bmboucher/nixie_ticker/bom/bom.txt

00 D6_1  08 D5_1  16 D3_4  24 D2_4
01 D6_8  09 D5_8  17 D3_2  25 D2_2
02 D6_2  10 D4_4  18 D3_8  26 D1_4
03 D6_4  11 D4_2  19 D3_1  27 D1_2
04 D5_4  12 D4_1  20 D2_A  28 D1_8
05 D5_2  13 D4_P  21 D2_P  29 D1_1
06 D6_A  14 D4_A  22 D3_A  30 D1_A
07 D5_A  15 D4_8  23 D2_8  31 D2_1
