bmboucher/nixie_ticker/bom/BOM.xlsx

Name | Description | Digikey | Manufacturer | Package | Notes
Power Supply
LED1,LED2 | Green LED | 160-1423-1-ND | LTST-C171GKT | 0805 | 2.1V forward, use 2k resistor for 5mA
R1,R2 | 0.47 Ohm, 1/4W, 5% Resistor | 73L4R47JCT-ND | 73L4R47J | 1206
R3 | 1 kOhm, 1/3W, 5% Resistor | A126435DKR-ND | CRGH0805J1K0 | 0805
R4 | 13.7kOhm, 1/4W, 1% Resistor | RHM13.7KCJCT-ND | MCR18ERTF1372 | 1206
R5 | 475kOhm, 1/4W, 1% Resistor | RMCF1206FG475KCT-ND | RMCF1206FG475K | 1206
R6 | 4.02kOhm, 1/4W, 1% Resistor | RHM4.02KCJCT-ND | MCR18ERTF4021 | 1206
R7,R8 | 2kOhm, 1/8W, 5% Resistor | RMCF0805JT2K00CT-ND | RMCF0805JT2K00 | 0805
RX | 2kOhm Trimmer Pot | 3309P-202-ND | 3309P-1-202 | Through hole
C1,C5,C6 | 220uF, 25V electrolytic cap | 493-2192-1-ND | UWT1E221MNL1GS | 8x10
C2 | 680pF, 50V ceramic cap | 732-7555-1-ND | 885012205060 | 0402
C3 | 0.01uF, 50V ceramic cap | 732-7562-1-ND | 885012205067 | 0402
C4 | 3.3uF, 250V electrolytic cap | 493-9981-1-ND | UUX2E3R3MNL1GS | 8x10
C7,C8 | 1uF, 10V ceramic cap | 445-7368-1-ND | C1005X6S1A105K050BC | 0402
D1 | 250V 50nS rectifier diode | BAV21WRHGCT-ND | BAV21W RHG | SOD-123F
D2 | 100V gen purpose diode | MMBD914LT1GOSCT-ND | MMBD914LT1G | SOT-23-3
D3 | 60V schottky diode | B260A-FDICT-ND | B260A-13-F | SMA | Already bought
Q1 | 200V N-channel MOSFET | IRF630NSTRLPBFCT-ND | IRF630NSTRLPBF | D2PAK
Q2 | 65V PNP Transistor | BC856BLT3GOSCT-ND | BC856BLT3G | SOT-23-3
U1 | IC Boost Regulator | MC34063ADGOS-ND | MC34063ADG | 8-SOIC
U2 | IC 5V Buck Regulator | 1034-AP1507-50D5LDICT-ND | AP1507-50D5L-13 | TO-252-5
U3 | Level shifter | 296-12163-1-ND | CD40109BPWR | 16-TSSOP
L1 | 100uH 1.4A inductor | RLB9012-101KL-ND | RLB9012-101KL | Through hole
L2 | 47uH 2.35A inductor | RLB0913-470K-ND | RLB0913-470K | Through hole
SW1,SW2 | Switches | EG4326-ND | 400MSP1R6BLKM6QE | Through hole
Phoenix | Phoenix contact | 277-1316-ND | 1706714 | Through hole
Phoenix Sep | Phoenix contact separator | 277-6463-ND | 1870666 |  |  | 0.001
DC Jack | 2.1mm DC power jack | EJ508A-ND | EJ508A | Through hole | Already bought
F1,F2 | 500mA fuse | 507-1876-1-ND | C1F 500
