bmboucher/nixie_ticker/box/acrylic_top.dxf

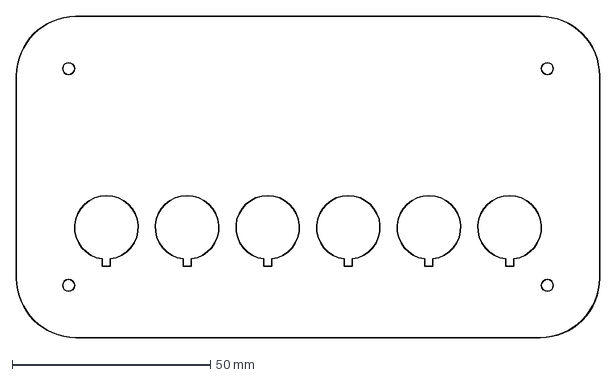
[picture p1: CAD file, 2018-09-05]
box/acrylic_top.dxf
147.0 x 81.0 mm
