bmboucher/nixie_ticker/cad/jigs/hinge_spacer.stl

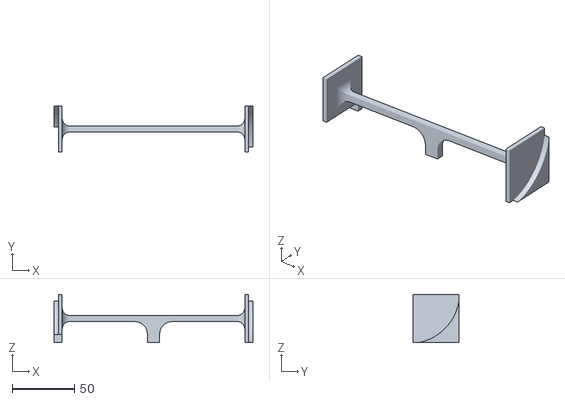
[picture p2: CAD file, 2018-09-05]
cad/jigs/hinge_spacer.stl
160.2 x 37.0 x 39.0
