bmboucher/nixie_ticker/cad/models/power_supply_board.step

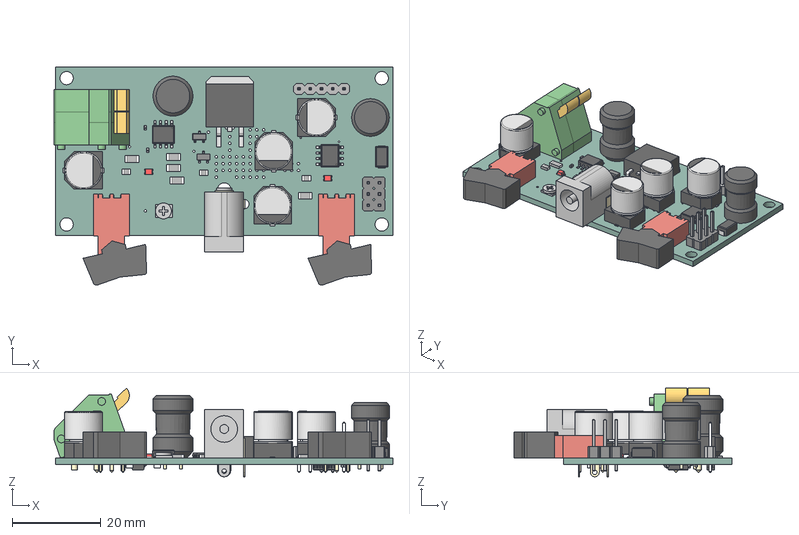
[picture p3: CAD file, 2018-08-29]
cad/models/power_supply_board.step
76.5 x 49.3 x 20.0 mm
Board
IRF630N
EJ508A
ZKFDS x 2
2X03
B260A-13-F
T411001B x 2
RLB9013
220uF x 4
SOD3616X115
SOT23
100uH
4.02k x 5
2k x 3
FUSE_1206 x 2
1X05
CD40109B_SPLITEN
AP1507SOIC-8 x 2
SOT23-BEC
2k_1
CHIP-LED0805 x 2
1uF x 4
