bmboucher/nixie_ticker/cad/parts/power_supply_spacer_back.stl

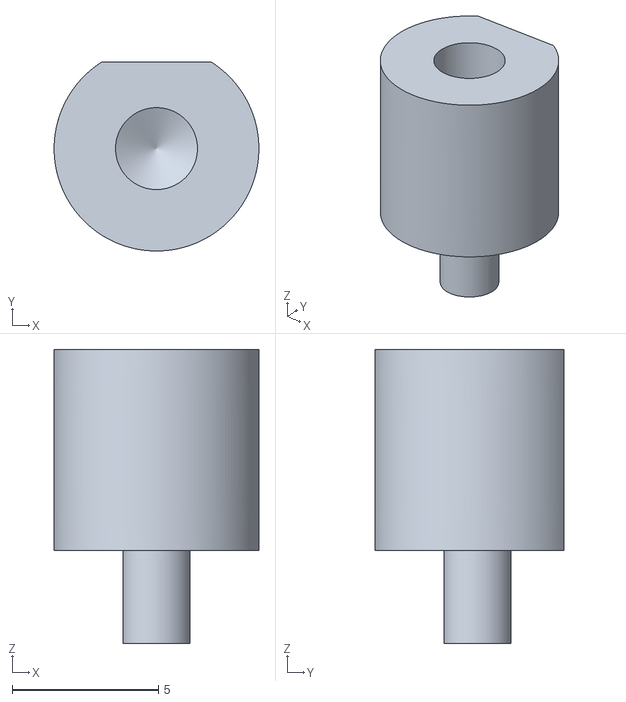
[picture p4: CAD file, 2018-09-01]
cad/parts/power_supply_spacer_back.stl
7.00 x 6.46 x 10.0
