bmboucher/nixie_ticker/box/top_piece.dxf

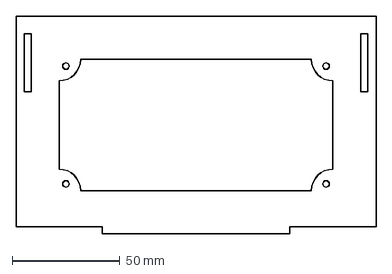
[picture p5: CAD file, 2018-07-10]
box/top_piece.dxf
167.0 x 101.0 mm
