bmboucher/nixie_ticker/cad/jigs/power_supply_stencil_spacer.stl

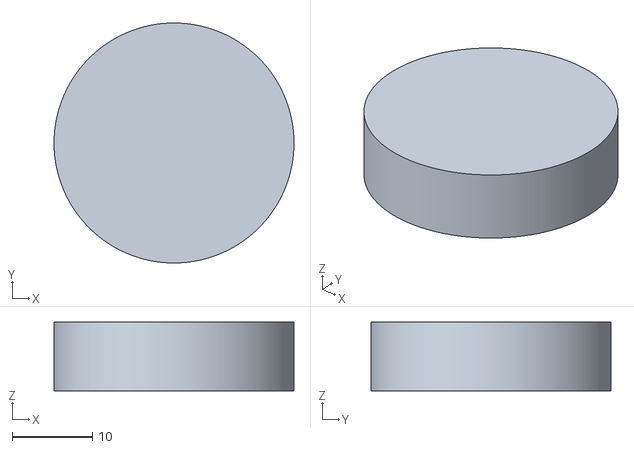
[picture p6: CAD file, 2018-08-30]
cad/jigs/power_supply_stencil_spacer.stl
30.0 x 30.0 x 8.60
