bmboucher/nixie_ticker/cad/models/in-14.step

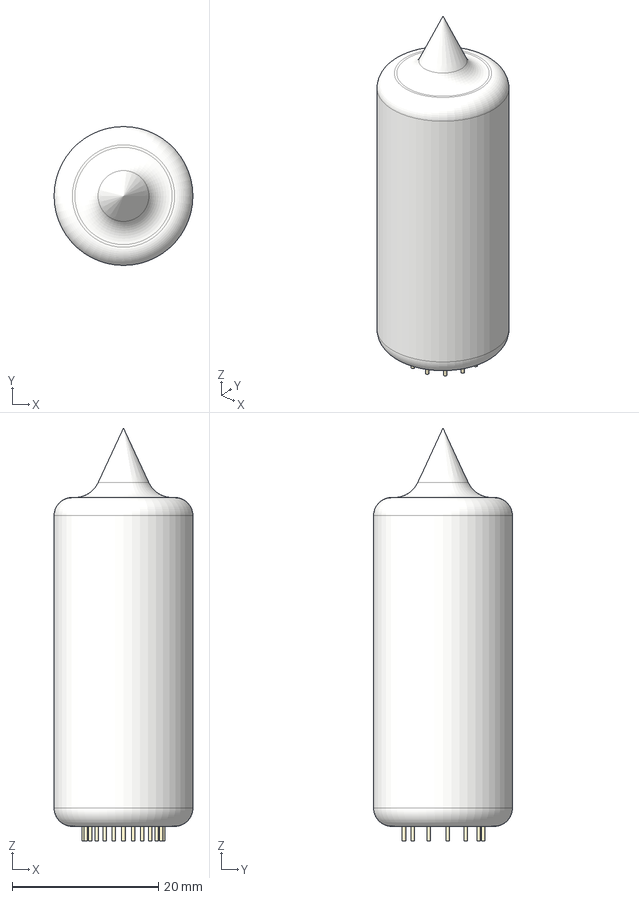
[picture p7: CAD file, 2018-08-29]
cad/models/in-14.step
19.0 x 19.0 x 56.5 mm
