bmboucher/nixie_ticker/cad/parts/power_supply_spacer_front.stl

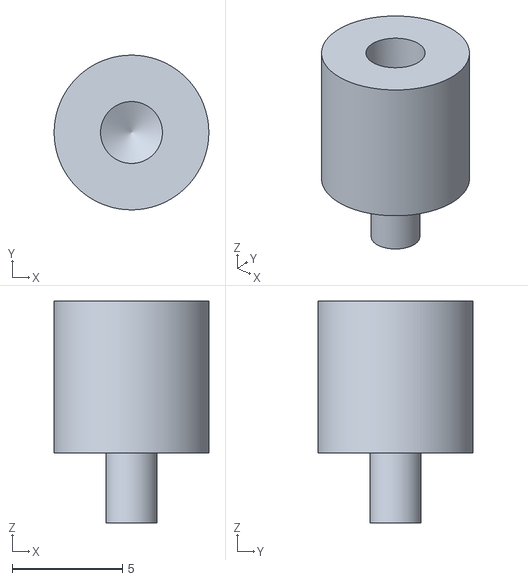
[picture p8: CAD file, 2018-09-01]
cad/parts/power_supply_spacer_front.stl
7.00 x 7.00 x 10.0
