bmboucher/nixie_ticker/box/front_piece.dxf

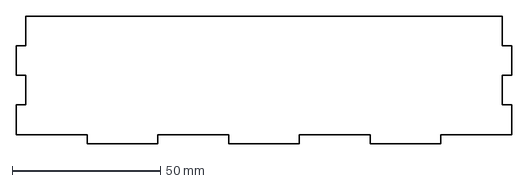
[picture p9: CAD file, 2018-07-10]
box/front_piece.dxf
167.0 x 43.2 mm
