bmboucher/nixie_ticker/cad/jigs/nixie_board_stencil_mount.stl

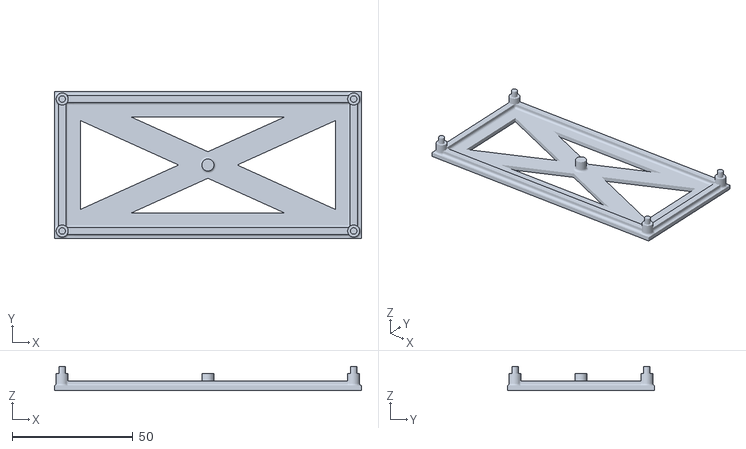
[picture p10: CAD file, 2018-08-30]
cad/jigs/nixie_board_stencil_mount.stl
127.1 x 61.0 x 10.0
