bmboucher/nixie_ticker/cad/models/nixie_board.step

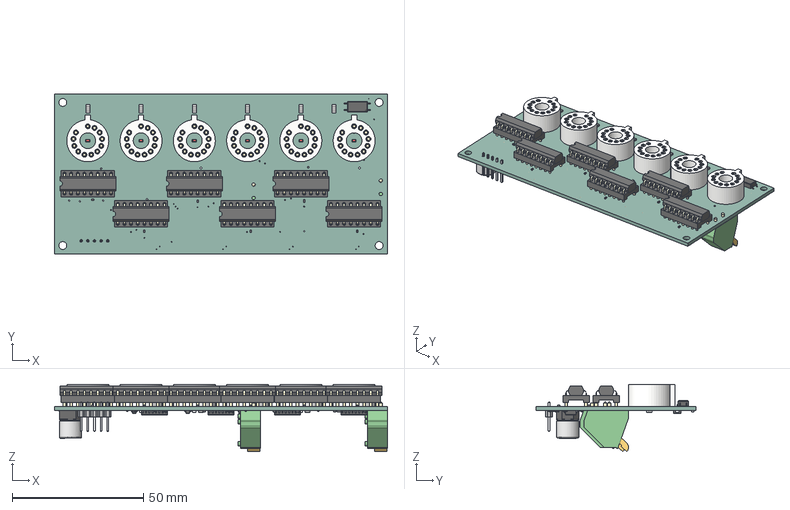
[picture p11: CAD file, 2018-08-29]
cad/models/nixie_board.step
127.0 x 61.0 x 25.7 mm
Board
BCX19SMD x 6
74AHC595 x 5
TLP3873D
ZKFDS x 2
1X05
220uF
22k x 6
10k x 12
CHIP-LED0603 x 6
C0402 x 16
100k x 12
IN14_12PIN12PIN x 6
