bmboucher/nixie_ticker/cad/parts/nixie_socket_tube.step

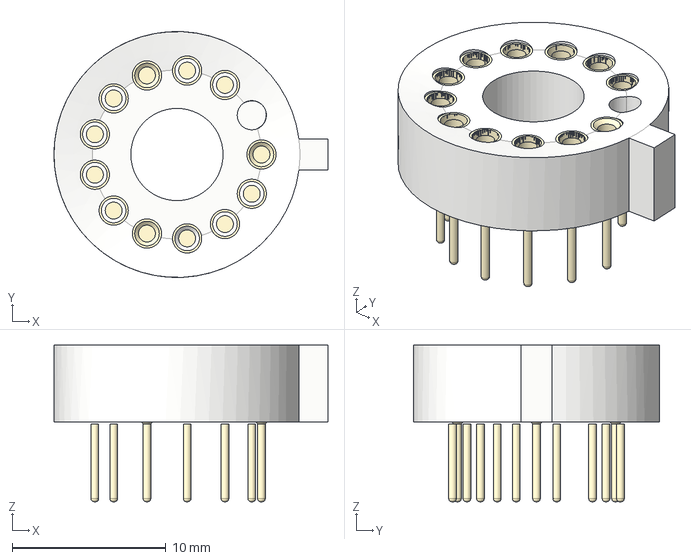
[picture p12: CAD file, 2018-08-29]
cad/parts/nixie_socket_tube.step
17.8 x 16.0 x 10.2 mm
