bmboucher/nixie_ticker/box/right_piece.dxf

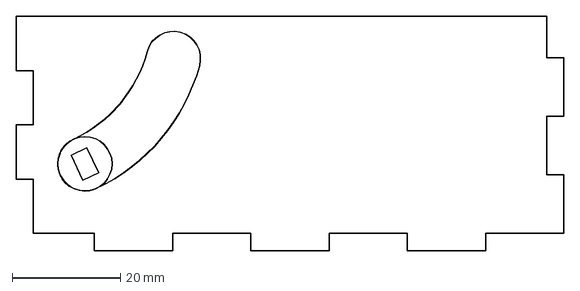
[picture p13: CAD file, 2018-07-10]
box/right_piece.dxf
101.0 x 43.2 mm
