bmboucher/nixie_ticker/cad/jigs/nixie_socket_alignment_tool.stl

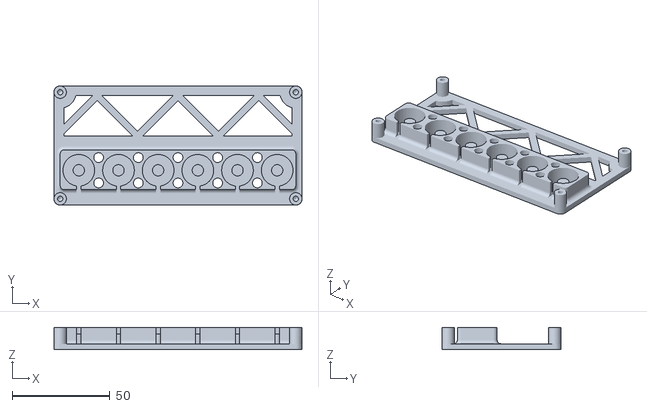
[picture p14: CAD file, 2018-08-29]
cad/jigs/nixie_socket_alignment_tool.stl
127.0 x 61.0 x 11.4
