bmboucher/nixie_ticker/cad/parts/nixie_socket_board.step

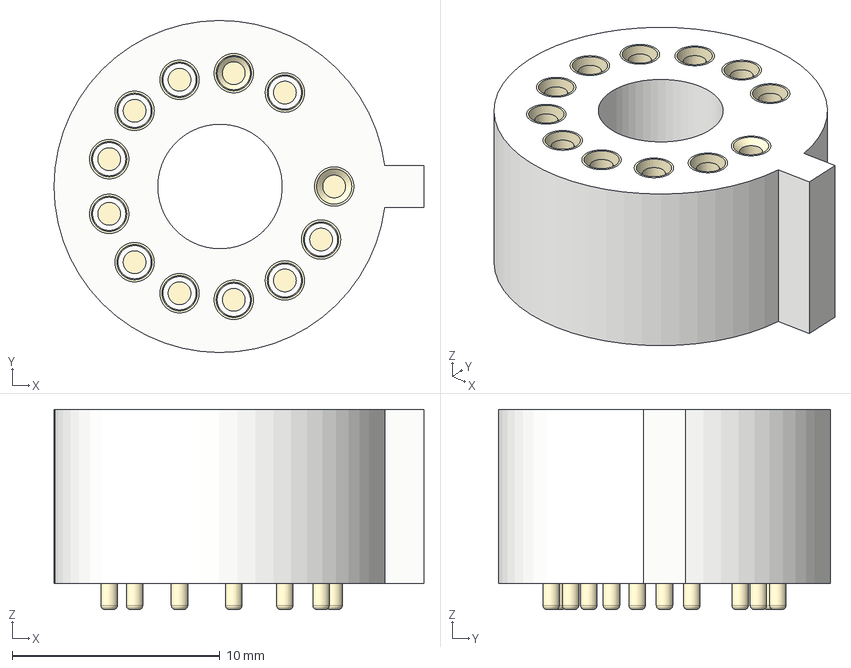
[picture p15: CAD file, 2018-08-29]
cad/parts/nixie_socket_board.step
17.8 x 16.0 x 9.64 mm
