bmboucher/nixie_ticker/box/support_3.dxf

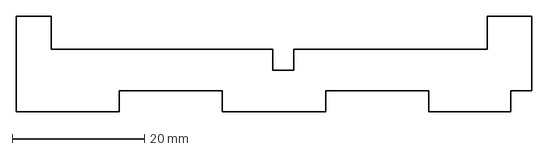
[picture p16: CAD file, 2018-07-10]
box/support_3.dxf
78.0 x 14.4 mm
