bmboucher/nixie_ticker/cad/jigs/power_supply_stencil_mount.stl

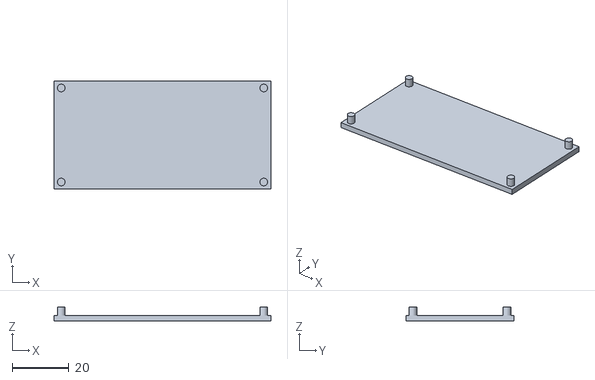
[picture p17: CAD file, 2018-08-29]
cad/jigs/power_supply_stencil_mount.stl
76.2 x 38.1 x 5.00
