bmboucher/nixie_ticker/box/left_piece.dxf

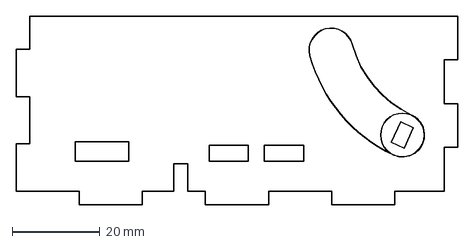
[picture p18: CAD file, 2018-07-10]
box/left_piece.dxf
101.0 x 43.2 mm
