bmboucher/nixie_ticker/cad/jigs/stencil_spacer.stl

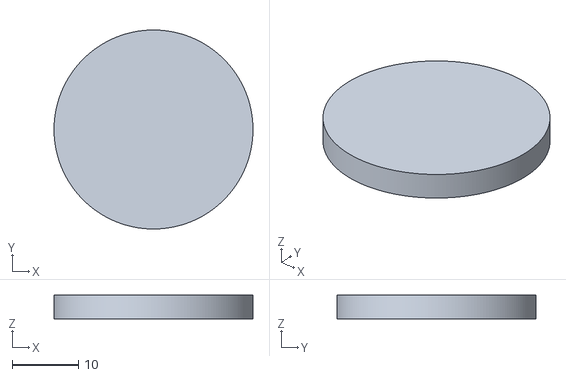
[picture p19: CAD file, 2018-08-29]
cad/jigs/stencil_spacer.stl
30.0 x 30.0 x 3.60
