bmboucher/nixie_ticker/box/bottom_piece.dxf

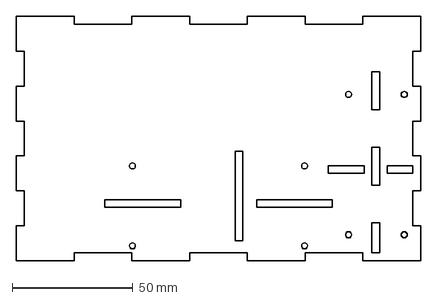
[picture p20: CAD file, 2018-07-10]
box/bottom_piece.dxf
167.0 x 101.0 mm
