bmboucher/nixie_ticker/box/hinge_circle.dxf

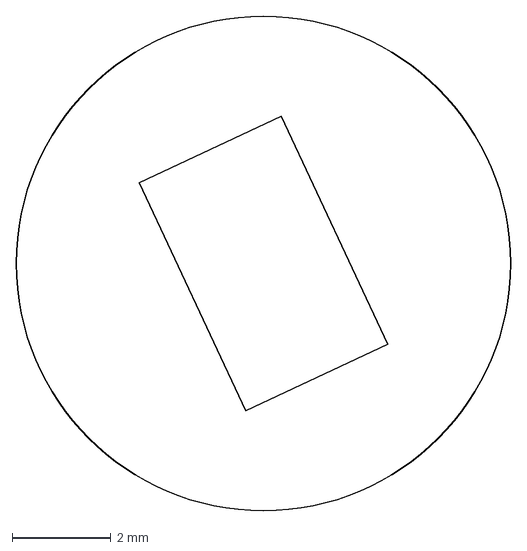
[picture p21: CAD file, 2018-07-10]
box/hinge_circle.dxf
10.00 x 10.00 mm
