bmboucher/nixie_ticker/box/support_1.dxf

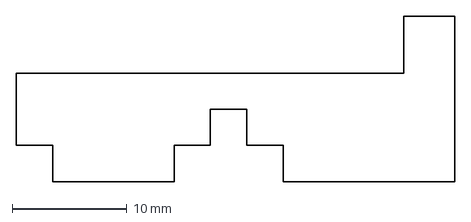
[picture p22: CAD file, 2018-07-10]
box/support_1.dxf
38.2 x 14.4 mm
