bmboucher/nixie_ticker/box/back_piece.dxf

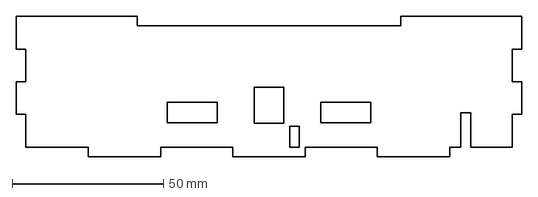
[picture p23: CAD file, 2018-07-10]
box/back_piece.dxf
167.0 x 46.3 mm
