bmboucher/nixie_ticker/box/support_2.dxf

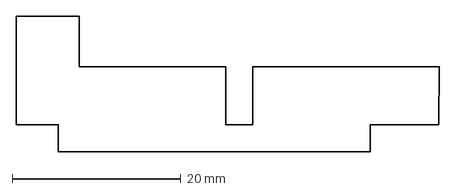
[picture p24: CAD file, 2018-07-10]
box/support_2.dxf
50.2 x 16.0 mm
