bmboucher/nixie_ticker/box/support_4.dxf

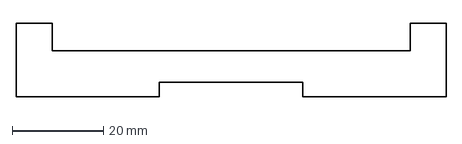
[picture p25: CAD file, 2018-07-10]
box/support_4.dxf
94.0 x 16.0 mm
