bmboucher/nixie_ticker/box/hinge_insert.dxf

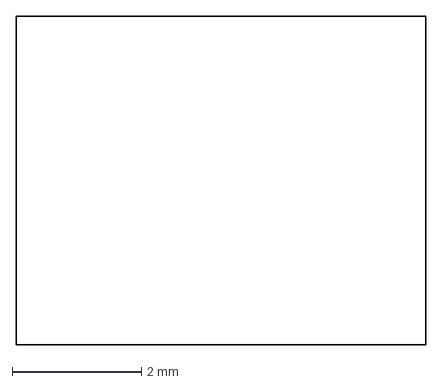
[picture p26: CAD file, 2018-07-10]
box/hinge_insert.dxf
6.35 x 5.09 mm
