bmboucher/nixie_ticker/box/hinge_piece.dxf

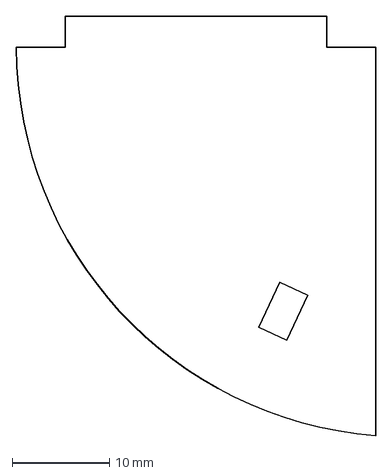
[picture p27: CAD file, 2018-07-10]
box/hinge_piece.dxf
37.0 x 43.2 mm
