bmboucher/nixie_ticker/(list of files, cad)

Other CAD files:
cad/parts/nixie_socket_board.stl
cad/parts/nixie_socket_tube.stl
