bmboucher/nixie_ticker/hardware/nixie_ticker.brd

## EAGLE design hardware/nixie_ticker.brd (2018-08-29)

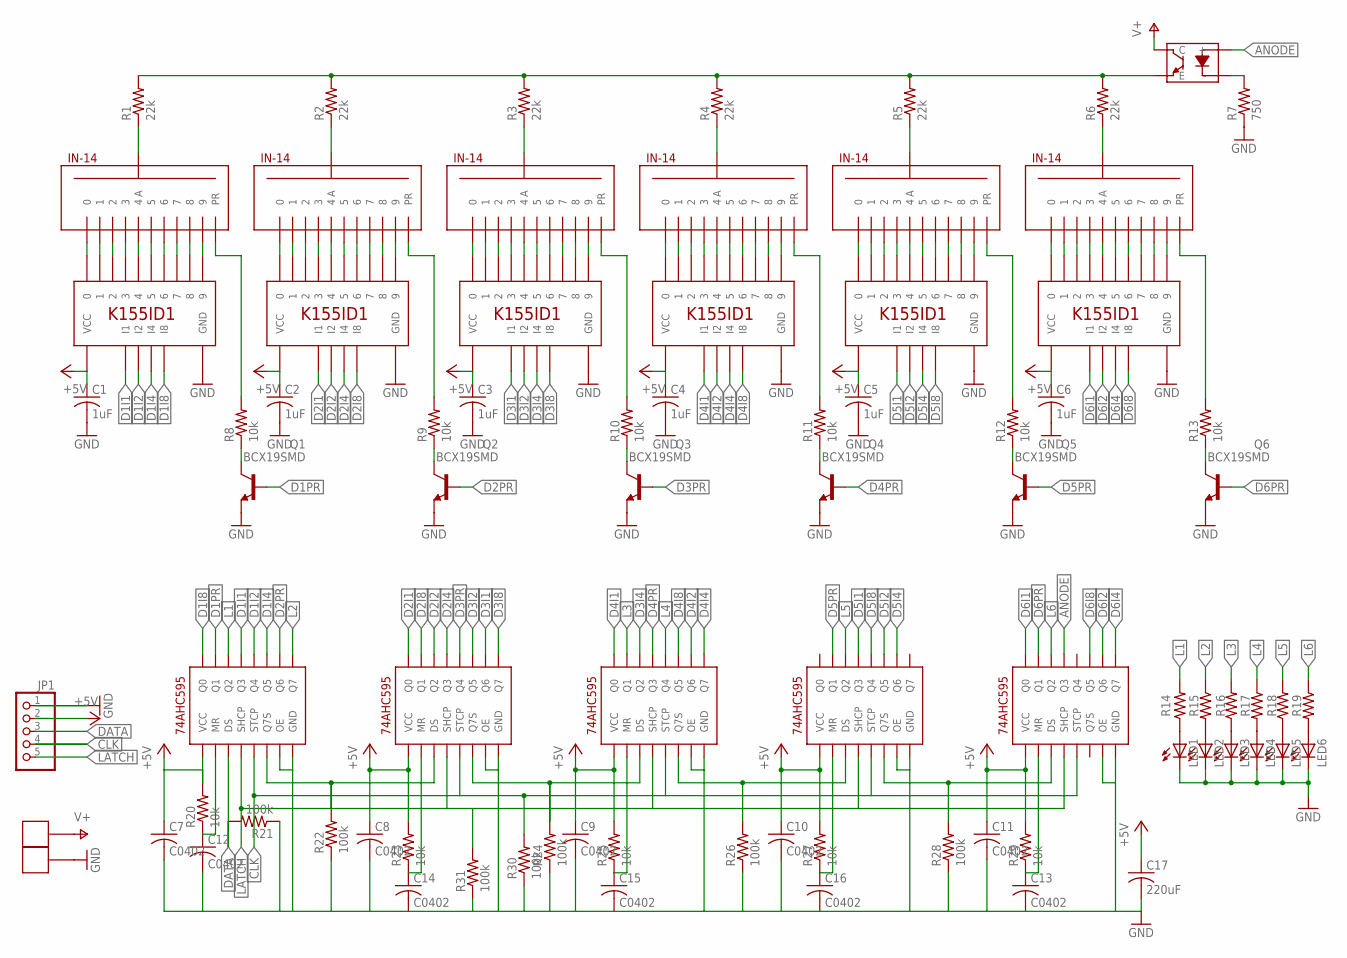
[picture p28: schematic nixie_ticker.sch]

Parts:
C1, C2, C3, C4, C5, C6: 1uF; C0402
C7, C8, C9, C10, C11, C12, C13, C14, C15, C16: C0402
C17: 220uF; CAPAE830X1050
JP1: PINHD-1X5; 1X05
JP2, JP3: ZKFDS
LED1, LED2, LED3, LED4, LED5, LED6: LEDCHIP-LED0603; CHIP-LED0603
N1, N2, N3, N4, N5, N6: IN14_12PIN12PIN; IN14-12PIN
Q1, Q2, Q3, Q4, Q5, Q6: BCX19SMD; SOT23-BEC
R1, R2, R3, R4, R5, R6: 22k; R1206
R7: 750; R0603
R8, R9, R10, R11, R12, R13: 10k; R0805
R14, R15, R16, R17, R18, R19: R-US_R0805; R0805
R20, R23, R25, R27, R29: 10k; R0402
R21, R22, R24, R26, R28, R30, R31: 100k; R0402
U1: TLP3873D; SOP254P1000X215-4
U2, U3, U4, U5, U6, U7: K155ID1; DIP-16_SMD
U8, U9, U10, U11, U12: 74AHC595; 16SOIC

Connections:
+5V: C1.1 (+), C2.1 (+), C3.1 (+), C4.1 (+), C5.1 (+), C6.1 (+), C7.1 (+), C8.1 (+), C9.1 (+), C10.1 (+), C11.1 (+), C17.1 (+), JP1.2, R20.2, R23.2, R25.2, R27.2, R29.2, U2.P$5 (VCC), U3.P$5 (VCC), U4.P$5 (VCC), U5.P$5 (VCC), U6.P$5 (VCC), U7.P$5 (VCC), U8.P$16 (VCC), U9.P$16 (VCC), U10.P$16 (VCC), U11.P$16 (VCC), U12.P$16 (VCC)
ANODE: U1.1 (+), U12.P$3 (Q3)
CLK: JP1.4, R30.2, U8.P$12 (STCP), U9.P$12 (STCP), U10.P$12 (STCP), U11.P$12 (STCP), U12.P$12 (STCP)
D1I1: U2.P$3 (I1), U8.P$3 (Q3)
D1I2: U2.P$6 (I2), U8.P$4 (Q4)
D1I4: U2.P$7 (I4), U8.P$5 (Q5)
D1I8: U2.P$4 (I8), U8.P$15 (Q0)
D1PR: Q1.B, U8.P$1 (Q1)
D2I1: U3.P$3 (I1), U9.P$15 (Q0)
D2I2: U3.P$6 (I2), U9.P$2 (Q2)
D2I4: U3.P$7 (I4), U9.P$3 (Q3)
D2I8: U3.P$4 (I8), U9.P$1 (Q1)
D2PR: Q2.B, U8.P$6 (Q6)
D3I1: U4.P$3 (I1), U9.P$6 (Q6)
D3I2: U4.P$6 (I2), U9.P$5 (Q5)
D3I4: U4.P$7 (I4), U10.P$2 (Q2)
D3I8: U4.P$4 (I8), U9.P$7 (Q7)
D3PR: Q3.B, U9.P$4 (Q4)
D4I1: U5.P$3 (I1), U10.P$15 (Q0)
D4I2: U5.P$6 (I2), U10.P$6 (Q6)
D4I4: U5.P$7 (I4), U10.P$7 (Q7)
D4I8: U5.P$4 (I8), U10.P$5 (Q5)
D4PR: Q4.B, U10.P$3 (Q3)
D5I1: U6.P$3 (I1), U11.P$3 (Q3)
D5I2: U6.P$6 (I2), U11.P$5 (Q5)
D5I4: U6.P$7 (I4), U11.P$6 (Q6)
D5I8: U6.P$4 (I8), U11.P$4 (Q4)
D5PR: Q5.B, U11.P$1 (Q1)
D6I1: U7.P$3 (I1), U12.P$15 (Q0)
D6I2: U7.P$6 (I2), U12.P$6 (Q6)
D6I4: U7.P$7 (I4), U12.P$7 (Q7)
D6I8: U7.P$4 (I8), U12.P$5 (Q5)
D6PR: Q6.B, U12.P$1 (Q1)
DATA: JP1.3, R21.2, U8.P$14 (DS)
GND: C1.2 (-), C2.2 (-), C3.2 (-), C4.2 (-), C5.2 (-), C6.2 (-), C7.2 (-), C8.2 (-), C9.2 (-), C10.2 (-), C11.2 (-), C12.2 (-), C13.2 (-), C14.2 (-), C15.2 (-), C16.2 (-), C17.2 (-), JP1.1, JP3.P$1, JP3.P$2, LED1.C, LED2.C, LED3.C, LED4.C, LED5.C, LED6.C, Q1.E, Q2.E, Q3.E, Q4.E, Q5.E, Q6.E, R7.1, R21.1, R22.1, R24.1, R26.1, R28.1, R30.1, R31.1, U2.P$12 (GND), U3.P$12 (GND), U4.P$12 (GND), U5.P$12 (GND), U6.P$12 (GND), U7.P$12 (GND), U8.P$8 (GND), U8.P$13 (OE), U9.P$8 (GND), U9.P$13 (OE), U10.P$8 (GND), U10.P$13 (OE), U11.P$8 (GND), U11.P$13 (OE), U12.P$8 (GND), U12.P$13 (OE)
L1: R14.2, U8.P$2 (Q2)
L2: R15.1, U8.P$7 (Q7)
L3: R16.2, U10.P$1 (Q1)
L4: R17.1, U10.P$4 (Q4)
L5: R18.2, U11.P$2 (Q2)
L6: R19.1, U12.P$2 (Q2)
LATCH: JP1.5, R31.2, U8.P$11 (SHCP), U9.P$11 (SHCP), U10.P$11 (SHCP), U11.P$11 (SHCP), U12.P$11 (SHCP)
unnamed: N1.P$12 (0), U2.P$16 (0)
unnamed: N1.P$3 (1), U2.P$15 (1)
unnamed: N1.P$4 (2), U2.P$8 (2)
unnamed: N1.P$5 (3), U2.P$9 (3)
unnamed: N1.P$6 (4), U2.P$13 (4)
unnamed: N1.P$7 (5), U2.P$14 (5)
unnamed: N1.P$8 (6), U2.P$11 (6)
unnamed: N1.P$9 (7), U2.P$10 (7)
unnamed: N1.P$10 (8), U2.P$1 (8)
unnamed: N1.P$11 (9), U2.P$2 (9)
unnamed: N2.P$12 (0), U3.P$16 (0)
unnamed: N2.P$3 (1), U3.P$15 (1)
unnamed: N2.P$4 (2), U3.P$8 (2)
unnamed: N2.P$5 (3), U3.P$9 (3)
unnamed: N2.P$6 (4), U3.P$13 (4)
unnamed: N2.P$7 (5), U3.P$14 (5)
unnamed: N2.P$8 (6), U3.P$11 (6)
unnamed: N2.P$9 (7), U3.P$10 (7)
unnamed: N2.P$10 (8), U3.P$1 (8)
unnamed: N2.P$11 (9), U3.P$2 (9)
unnamed: R24.2, U9.P$9 (Q7S), U10.P$14 (DS)
unnamed: R22.2, U8.P$9 (Q7S), U9.P$14 (DS)
unnamed: R26.2, U10.P$9 (Q7S), U11.P$14 (DS)
unnamed: R28.2, U11.P$9 (Q7S), U12.P$14 (DS)
unnamed: LED2.A, R15.2
unnamed: C13.1 (+), R29.1, U12.P$10 (MR)
unnamed: LED3.A, R16.1
unnamed: LED1.A, R14.1
unnamed: LED4.A, R17.2
unnamed: N3.P$12 (0), U4.P$16 (0)
unnamed: N3.P$3 (1), U4.P$15 (1)
unnamed: N3.P$4 (2), U4.P$8 (2)
unnamed: N3.P$5 (3), U4.P$9 (3)
unnamed: N3.P$6 (4), U4.P$13 (4)
unnamed: N3.P$7 (5), U4.P$14 (5)
unnamed: N3.P$8 (6), U4.P$11 (6)
unnamed: N3.P$9 (7), U4.P$10 (7)
unnamed: N3.P$10 (8), U4.P$1 (8)
unnamed: N3.P$11 (9), U4.P$2 (9)
unnamed: LED5.A, R18.1
unnamed: LED6.A, R19.2
unnamed: N1.P$2 (PR), R8.2
unnamed: Q1.C, R8.1
unnamed: N3.P$2 (PR), R10.2
unnamed: Q3.C, R10.1
unnamed: N5.P$2 (PR), R12.2
unnamed: Q5.C, R12.1
unnamed: N6.P$2 (PR), R13.2
unnamed: Q6.C, R13.1
unnamed: N1.P$1 (A), R1.1
unnamed: N4.P$12 (0), U5.P$16 (0)
unnamed: N4.P$3 (1), U5.P$15 (1)
unnamed: N4.P$4 (2), U5.P$8 (2)
unnamed: N4.P$5 (3), U5.P$9 (3)
unnamed: N4.P$6 (4), U5.P$13 (4)
unnamed: N4.P$7 (5), U5.P$14 (5)
unnamed: N4.P$8 (6), U5.P$11 (6)
unnamed: N4.P$9 (7), U5.P$10 (7)
unnamed: N4.P$10 (8), U5.P$1 (8)
unnamed: N4.P$11 (9), U5.P$2 (9)
unnamed: N5.P$1 (A), R5.1
unnamed: N5.P$12 (0), U6.P$16 (0)
unnamed: N5.P$3 (1), U6.P$15 (1)
unnamed: N5.P$4 (2), U6.P$8 (2)
unnamed: N5.P$5 (3), U6.P$9 (3)
unnamed: N5.P$6 (4), U6.P$13 (4)
unnamed: N5.P$7 (5), U6.P$14 (5)
unnamed: N5.P$8 (6), U6.P$11 (6)
unnamed: N5.P$9 (7), U6.P$10 (7)
unnamed: N5.P$10 (8), U6.P$1 (8)
unnamed: N5.P$11 (9), U6.P$2 (9)
unnamed: R1.2, R2.2, R3.2, R4.2, R5.2, R6.2, U1.3 (E)
unnamed: R7.2, U1.2 (-)
unnamed: N6.P$1 (A), R6.1
unnamed: N2.P$1 (A), R2.1
unnamed: C14.1 (+), R23.1, U9.P$10 (MR)
unnamed: C12.1 (+), R20.1, U8.P$10 (MR)
unnamed: C15.1 (+), R25.1, U10.P$10 (MR)
unnamed: C16.1 (+), R27.1, U11.P$10 (MR)
unnamed: N3.P$1 (A), R3.1
unnamed: N6.P$12 (0), U7.P$16 (0)
unnamed: N6.P$3 (1), U7.P$15 (1)
unnamed: N6.P$4 (2), U7.P$8 (2)
unnamed: N6.P$5 (3), U7.P$9 (3)
unnamed: N6.P$6 (4), U7.P$13 (4)
unnamed: N6.P$7 (5), U7.P$14 (5)
unnamed: N6.P$8 (6), U7.P$11 (6)
unnamed: N6.P$9 (7), U7.P$10 (7)
unnamed: N6.P$10 (8), U7.P$1 (8)
unnamed: N6.P$11 (9), U7.P$2 (9)
unnamed: N4.P$1 (A), R4.1
unnamed: Q2.C, R9.1
unnamed: Q4.C, R11.1
unnamed: N4.P$2 (PR), R11.2
unnamed: N2.P$2 (PR), R9.2
V+: JP2.P$1, JP2.P$2, U1.4 (C)

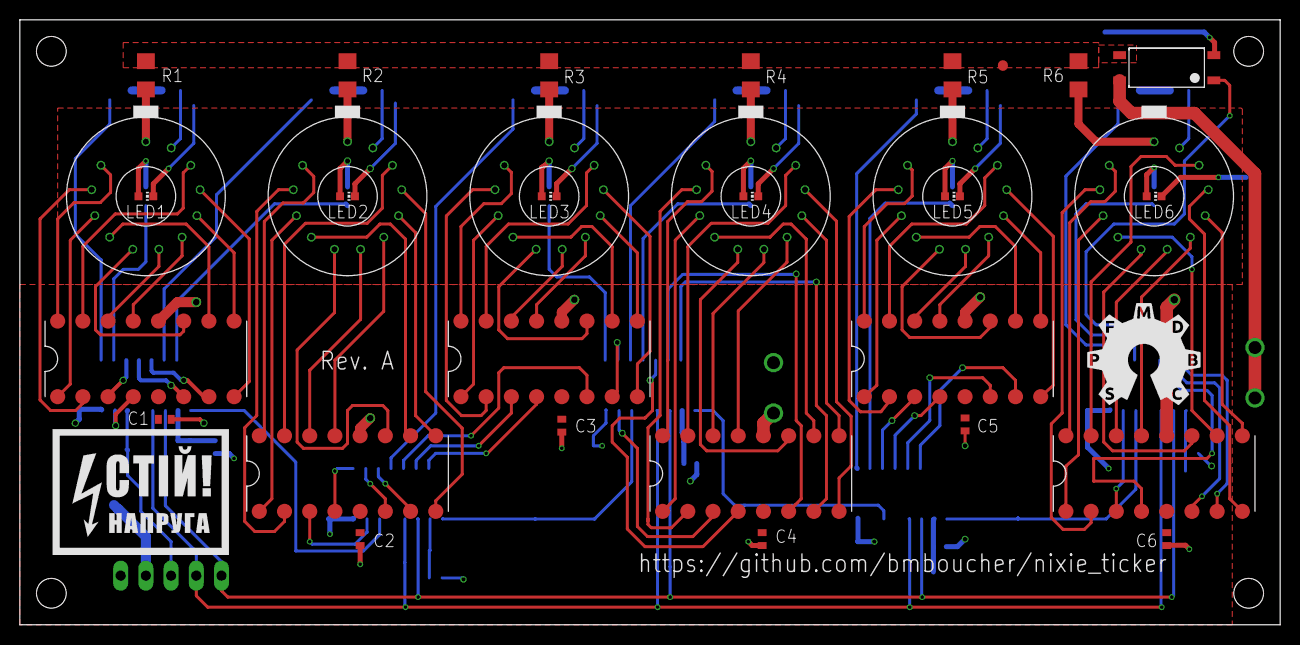
[picture p29: board nixie_ticker.brd from above]

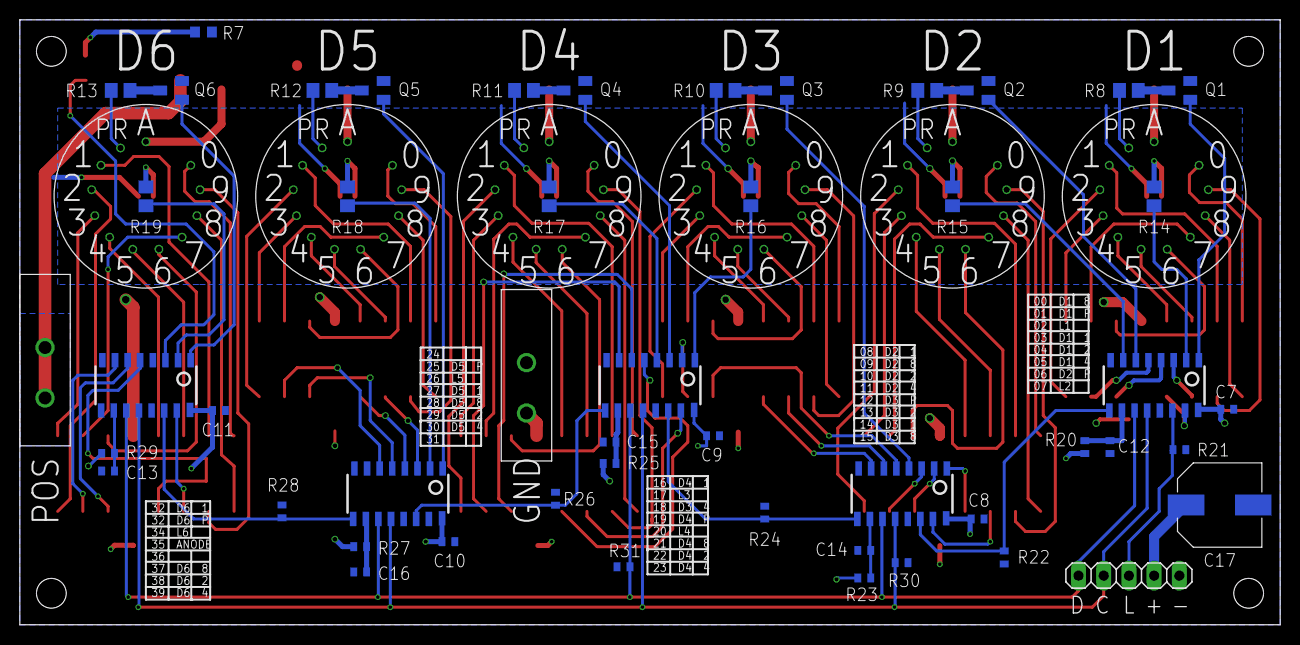
[picture p30: board nixie_ticker.brd from below]

Board: 2 copper layers, 127.0 x 61.0 mm, 81 parts (50 on the bottom side), 138 nets.
