bmboucher/nixie_ticker/hardware/power_supply.brd

## EAGLE design hardware/power_supply.brd (2018-08-29)

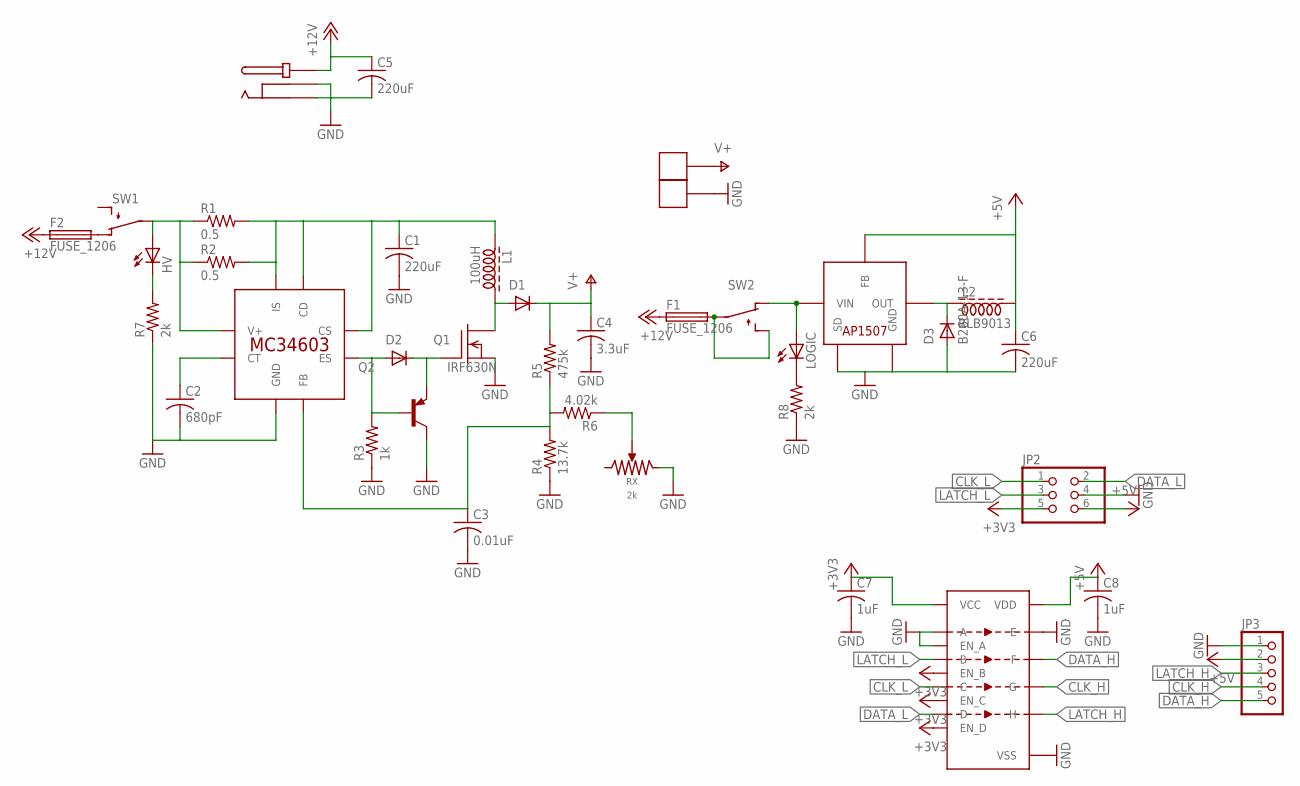
[picture p31: schematic power_supply.sch]

Parts:
C1, C5, C6: 220uF; CAPAE830X1050
C2: 680pF; C0402
C3: 0.01uF; C0402
C4: 3.3uF; CAPAE830X1050
C7, C8: 1uF; C0402
D1: BAV21W; SOD3616X115
D2: MMBD914L; SOT23
D3: B260A-13-F; DIOM4326X230
F1, F2: FUSE_1206; R1206
HV: LEDCHIP-LED0805; CHIP-LED0805
JP2: PINHD-2X3; 2X03
JP3: PINHD-1X5; 1X05
L1: 100uH; RLB9012
L2: RLB9013
LOGIC: LEDCHIP-LED0805; CHIP-LED0805
Q1: IRF630N; TO254P1524X483-3
Q2: BC807-16-PNP-SOT23-BEC; SOT23-BEC
R1, R2: 0.5; R1206
R3: 1k; R0805
R4: 13.7k; R1206
R5: 475k; R1206
R6: 4.02k; R1206
R7, R8: 2k; R0805
RX: 2k; TC33X-2
SW1, SW2: T411001B
U1: MC34063; SOIC127P600X175-8
U2: AP1507SOIC-8; SOIC127P600X175-8
U3: CD40109B_SPLITEN; SOP65P640X120-16
U$1: EJ508A
U$5, U$6: ZKFDS

Connections:
+3V3: C7.1 (+), JP2.5, U3.1 (VCC), U3.7 (EN_B), U3.9 (EN_C), U3.15 (EN_D)
+5V: C6.1 (+), C8.1 (+), JP2.6, JP3.2, L2.P$2 (2), U2.3 (FB), U3.16 (VDD)
+12V: C5.1 (+), F1.1, F2.1, U$1.P$1
CLK_H: JP3.4, U3.11 (G)
CLK_L: JP2.1, U3.10 (C)
DATA_H: JP3.5, U3.5 (F)
DATA_L: JP2.2, U3.14 (D)
GND: C1.2 (-), C2.2 (-), C3.2 (-), C4.2 (-), C5.2 (-), C6.2 (-), C7.2 (-), C8.2 (-), D3.2 (A), JP2.4, JP3.1, Q1.2 (S), Q2.C, R3.1, R4.1, R7.1, R8.1, RX.P$3, U1.4 (GND), U2.4 (SD), U2.5 (GND), U2.6 (GND), U2.7 (GND), U2.8 (GND), U3.2 (EN_A), U3.3 (A), U3.4 (E), U3.8 (VSS), U3.12 (VSS), U$1.P$2, U$1.P$3, U$6.P$1, U$6.P$2
LATCH_H: JP3.3, U3.13 (H)
LATCH_L: JP2.3, U3.6 (B)
unnamed: C1.1 (+), L1.P$1 (1), R1.2, R2.2, U1.1 (CS), U1.7 (IS), U1.8 (CD)
unnamed: D1.1 (A), L1.P$2 (2), Q1.3 (D)
unnamed: R6.1, RX.P$2
unnamed: D2.1 (A), Q2.B, R3.2, U1.2 (ES)
unnamed: D2.3 (C), Q1.1 (G), Q2.E
unnamed: HV.A, R1.1, R2.1, SW1.P$2 (2), U1.6 (V+)
unnamed: C2.1 (+), U1.3 (CT)
unnamed: LOGIC.A, SW2.P$1 (1), U2.1 (VIN)
unnamed: C3.1 (+), R4.2, R5.1, R6.2, U1.5 (FB)
unnamed: D3.1 (C), L2.P$1 (1), U2.2 (OUT)
unnamed: HV.C, R7.2
unnamed: LOGIC.C, R8.2
unnamed: F1.2, SW2.P$2 (2), SW2.P$3 (3)
unnamed: F2.2, SW1.P$1 (1)
V+: C4.1 (+), D1.2 (C), R5.2, U$5.P$1, U$5.P$2

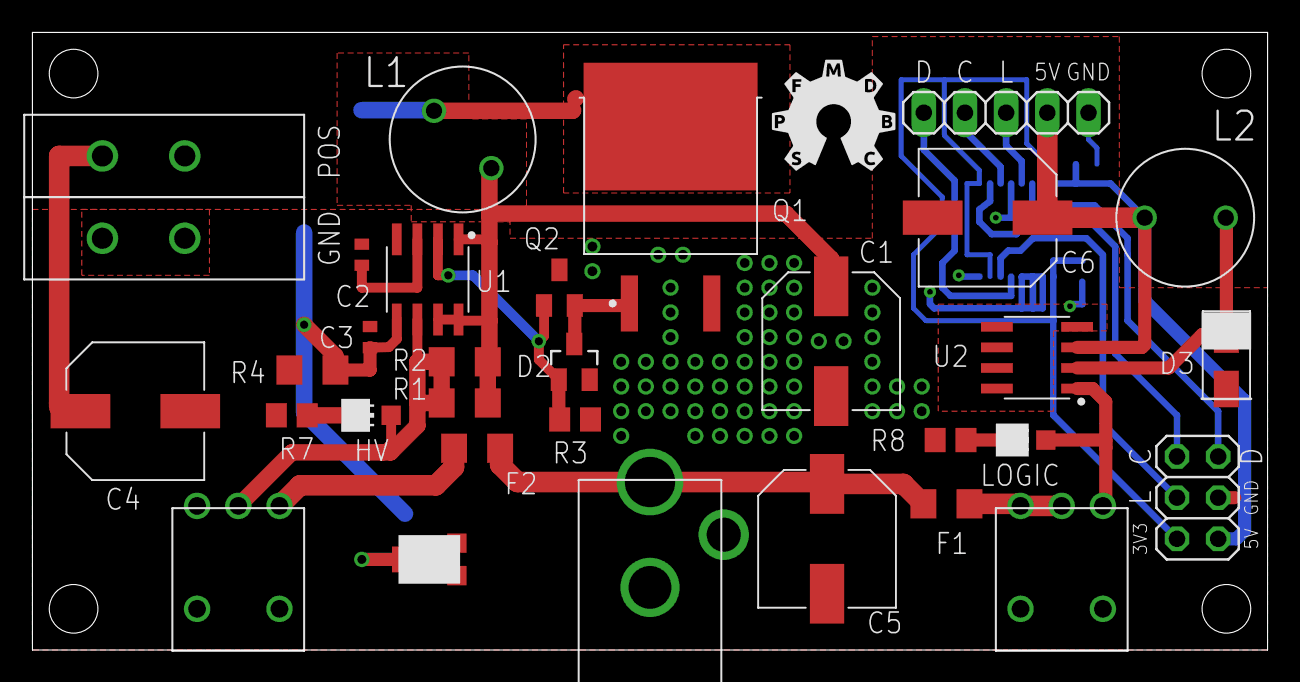
[picture p32: board power_supply.brd from above]

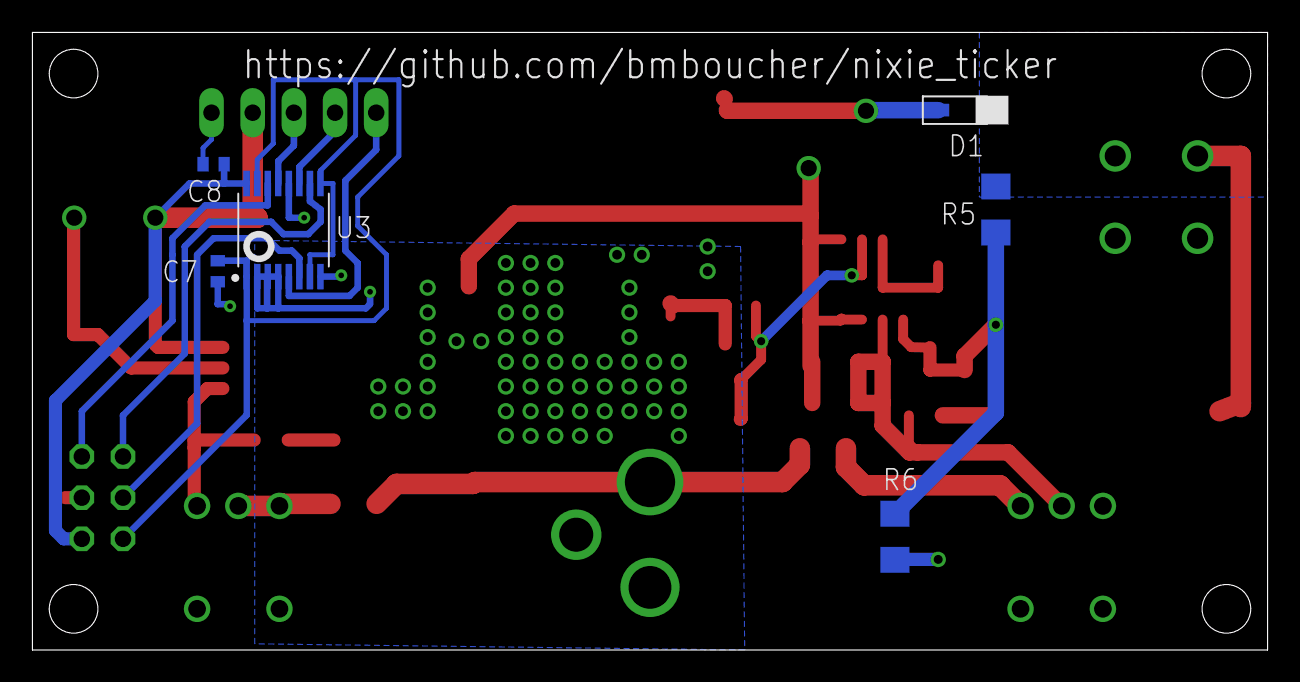
[picture p33: board power_supply.brd from below]

Board: 2 copper layers, 76.2 x 38.1 mm, 38 parts (6 on the bottom side), 25 nets.
