bmboucher/nixie_ticker/(commit log)

2018-06-27 Initial placing of nixies and drivers
    [nixie_ticker.brd, nixie_ticker.sch]
2018-06-27 Initial routing for first nixie
    [nixie_ticker.brd]
2018-06-27 Wiring all nixie tubes using design blocks
    [nixie_ticker.brd, nixie_ticker.sch]
2018-06-27 Removing grid lines
    [nixie_ticker.brd]
2018-06-28 Adding high voltage logo
    [nixie_ticker.brd, nixie_ticker.sch]
2018-06-28 Adding optocouplers to drive anodes
    [nixie_ticker.brd, nixie_ticker.sch]
2018-06-28 Adding high-voltage rail
    [nixie_ticker.brd]
2018-06-29 Updates 6-29
    [nixie_ticker.brd, nixie_ticker.sch]
2018-07-01 Finalizing board 7-1
    [nixie_ticker.brd, nixie_ticker.sch]
2018-07-07 Updates 7-7
    [nixie_ticker.brd, power_supply.brd, power_supply.sch]
2018-07-10 Updating power supply 7/10
    [power_supply.brd, power_supply.sch]
2018-07-10 Adding box
    [back_piece.dxf, bottom_piece.dxf, front_piece.dxf, hinge_circle.dxf, hinge_insert.dxf, hinge_piece.dxf, left_piece.dxf, right_piece.dxf]
2018-07-11 Updating power_supply, 7-11
    [power_supply.brd, power_supply.sch]
2018-07-16 Updating power_supply
    [power_supply.brd, power_supply.sch]
2018-08-12 Updating 8-12
    [BOM.xlsx, nixie_ticker.brd, nixie_ticker.sch, power_supply.brd, power_supply.sch]
2018-08-12 Changing OSH logo on power supply
    [nixie_ticker.brd]
2018-08-17 Updates 8-17, adding fifth shift register
    [nixie_ticker.brd, nixie_ticker.sch, power_supply.brd]
2018-08-17 Updates to BOM
    [BOM.xlsx, nixie_ticker.brd, nixie_ticker.sch, power_supply.brd, power_supply.sch]
2018-08-18 Final update before submitting to PCB shop
    [BOM.xlsx, BOM_Digikey_PowerSupply.csv, nixie_ticker.brd, nixie_ticker.sch, power_supply.brd, power_supply.sch]
2018-08-29 Adding CAD files
    [in-14.step, nixie_board.step, nixie_socket_board.step, nixie_socket_board.stl, nixie_socket_board_alignment_tool.stl, nixie_socket_tube.step, nixie_socket_tube.stl, power_supply_board.step]
2018-08-29 Updates 8-28
    [nixie_ticker.brd, nixie_ticker.sch, power_supply.brd, power_supply.sch]
2018-08-30 Adding stencil mounts/spacers to CAD
    [nixie_ticker_stencil_mount.stl, power_supply_stencil_spacer.stl]
2018-08-30 Fixing compilation errors in software
    [nixie_driver.cpp]
2018-08-30 Adding reset to initialization for NixieDisplay
    [nixie_driver.cpp]
2018-08-30 Fixing log mesage in test_single_register
    [nixie_driver.cpp]
2018-08-30 Adding string parsing to software driver
2018-08-30 Adding led++
2018-08-30 Fixing terminal decimal point in NixieDisplay::write
    [nixie_driver.cpp]
2018-08-30 Adding digit reversal to nixies
    [nixie_driver.cpp]
2018-08-30 Adding exception to digit reversal for >9 digits
    [nixie_driver.cpp]
2018-08-30 Adding fix to decimal point location
    [nixie_driver.cpp]
2018-08-31 Fixing digit reversal for 0/1
    [nixie_driver.cpp]
2018-09-01 Adding power supply spacers to CAD
    [power_supply_spacer_back.stl, power_supply_spacer_front.stl]
2018-09-01 Adding cycling LEDs to nixie_clock
2018-09-05 Changing holes in acrylic top
    [acrylic_top.dxf]
2018-09-05 Adding hinge spacer tool
    [hinge_spacer.stl]
2018-09-05 Fixing pointer compilation error
    [nixie_ticker.cpp]
2018-09-05 Adding url printer
2018-09-05 Changing type of current_ticker
2018-09-05 Printing all tickers
2018-09-05 Printing url again
2018-09-05 Extending TICKER_SWITCH, shortening TICK_DELAY
    [nixie_ticker.cpp]
